ZipTheFile/TaikoNoTatsujinDrum/Ressource/SidePhoto.jpg

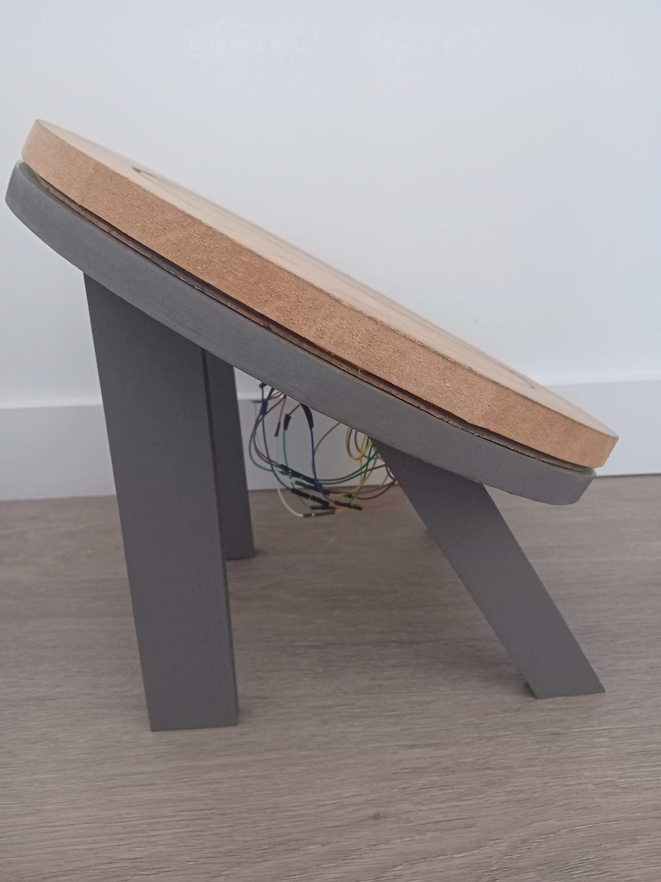
Ressource/SidePhoto.jpg
