ZipTheFile/TaikoNoTatsujinDrum/Ressource/Layers.jpg

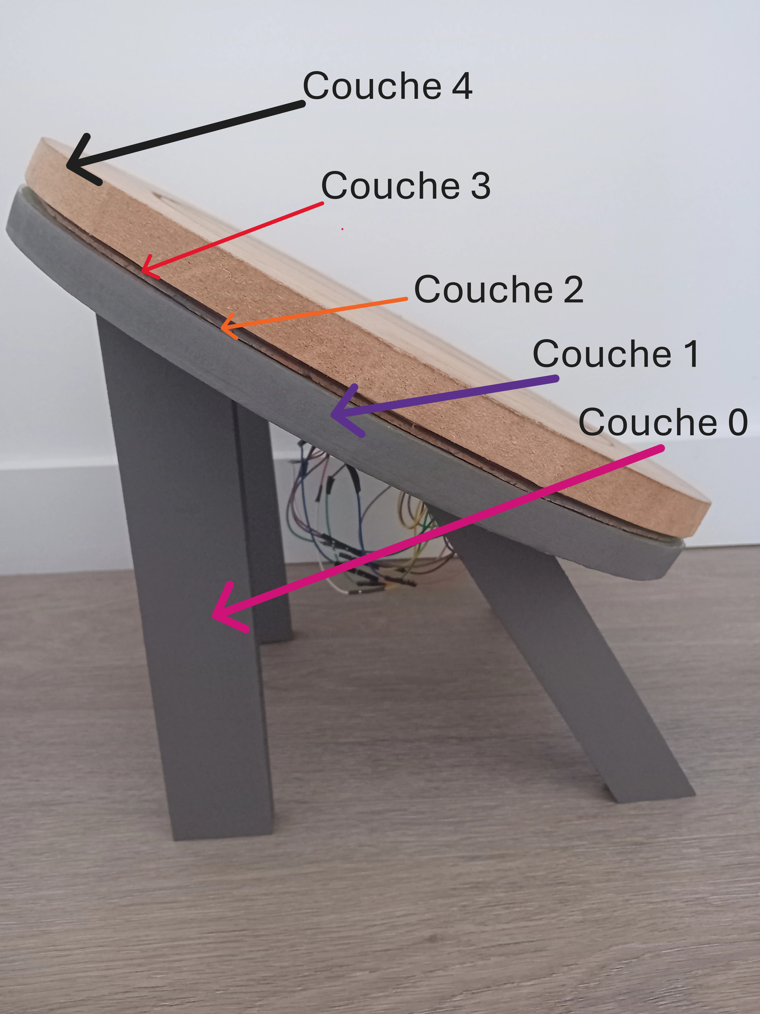
[picture p2: Ressource/Layers.jpg]
Ressource/Layers.jpg
