ZipTheFile/TaikoNoTatsujinDrum/Ressource/FeetAngles.jpg

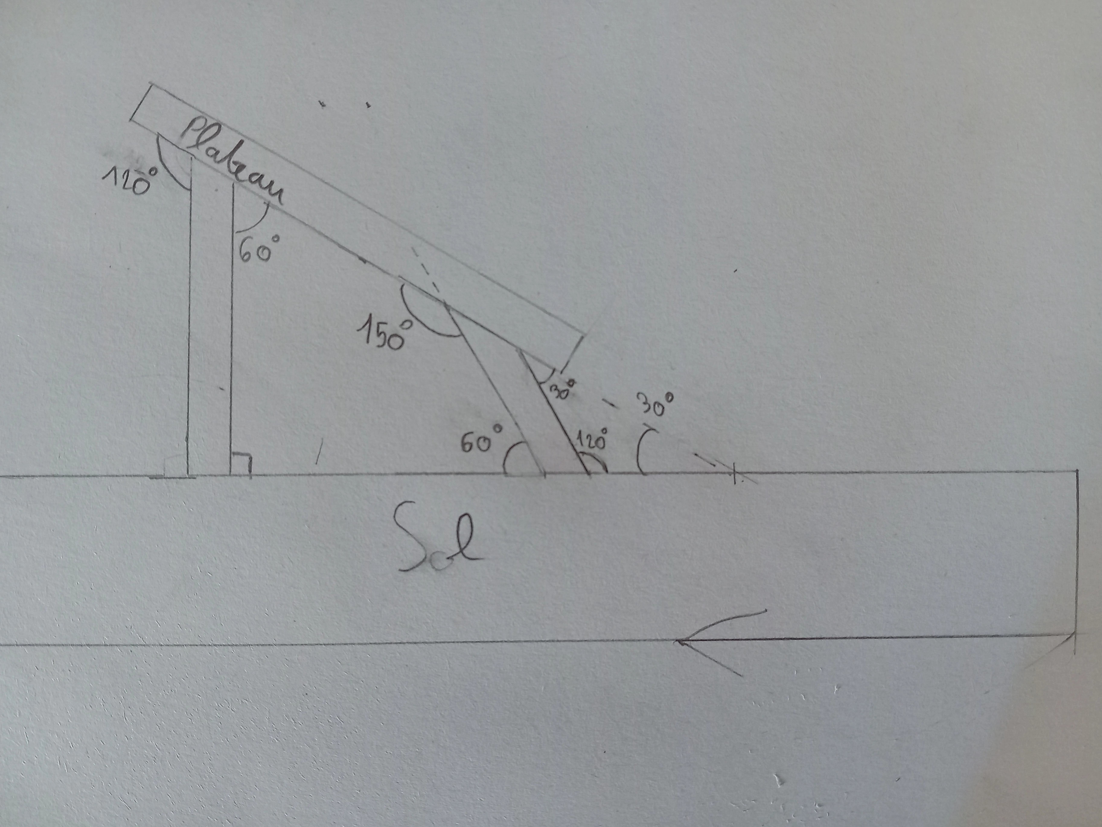
[picture p3: Ressource/FeetAngles.jpg]
Ressource/FeetAngles.jpg
